rudy1904/Knobpad/README.md

# Knob — panda MIDI keypad

Panda-shaped USB-MIDI controller for Hack Club Half Life (Tier 1): 8 Kailh Choc V1 keys, EC11 encoder, rotary pot, WS2812B underglow, LOLIN S3 Mini (ESP32-S3).

## Status

| Phase | State |
| --- | --- |
| 1. Prep — parts, pinout, footprints | done → `docs/phase1-prep.md` |
| 2. Schematic | done, in review → `docs/phase2-4.md` (ERC 0/0) |
| 3. Footprints + pin check | done, in review → `docs/phase2-4.md` |
| 4. Panda outline | done, in review → `docs/phase2-4.md` (96 × 94 mm, DRC 0) |
| 5. Placement | not started |
| 6. Routing | not started |
| 7. Silkscreen art | not started |
| 8. DRC + exports | not started |
| 9. Firmware | not started |
| 10. Repo + submit | not started |

## Layout

```
hardware/        KiCad 10 project — open hardware/knob.kicad_pro
hardware/lib/    project-local footprints/symbols (Choc V1, S3 Mini)
firmware/        CircuitPython (Phase 9)
docs/            phase notes, parts draft, schematic PDF, images
reports/         ERC / DRC reports
```

`BOM.md` and `JOURNAL.md` are generated by Half Life on sync — don't hand-edit them.
