rudy1904/Knobpad/docs/ref/README.md

# Reference documents (official sources)

- LOLIN S3 Mini page (pinout image, specs): https://www.wemos.cc/en/latest/s3/s3_mini.html
- S3 Mini schematic v1.0.0: https://www.wemos.cc/en/latest/_static/files/sch_s3_mini_v1.0.0.pdf
- S3 Mini dimensions v1.0.0: https://www.wemos.cc/en/latest/_static/files/dim_s3_mini_v1.0.0.pdf
- CircuitPython board pins (lolin_s3_mini): https://github.com/adafruit/circuitpython/blob/main/ports/espressif/boards/lolin_s3_mini/pins.c
- ESP32-S3 datasheet: https://www.espressif.com/sites/default/files/documentation/esp32-s3_datasheet_en.pdf
- WS2812B-B/T datasheet (LCSC C2761795): https://datasheet.lcsc.com/datasheet/pdf/bc8264a6d62c958a89e25ec8cc82b690.pdf?productCode=C2761795
- Bourns PTV09 datasheet: https://www.bourns.com/data/global/pdfs/PTV09.pdf
- Alps EC11E18244A5 (LCSC C255515): https://www.lcsc.com/product-detail/C255515.html
- Kailh Choc V1 footprint source: https://github.com/kiswitch/keyswitch-kicad-library

Wemos' site blocks direct downloads from scripts; open these in a browser and drop the PDFs here if you want offline copies.
