rudy1904/Knobpad/docs/img/cover.png

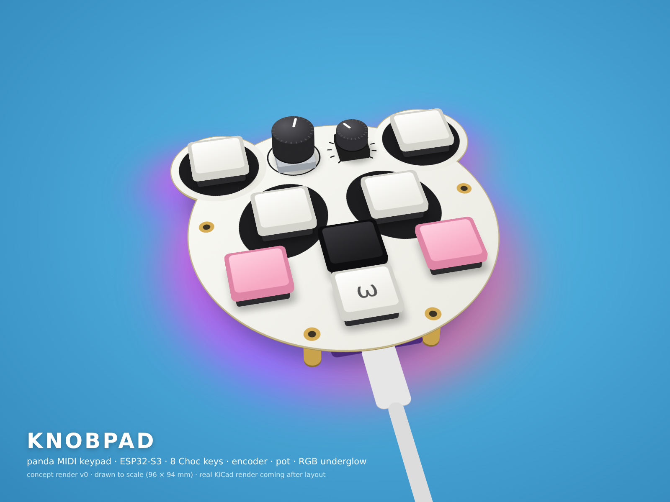
docs/img/cover.png
