rudy1904/Knobpad/docs/img/phase1-pinmap.png

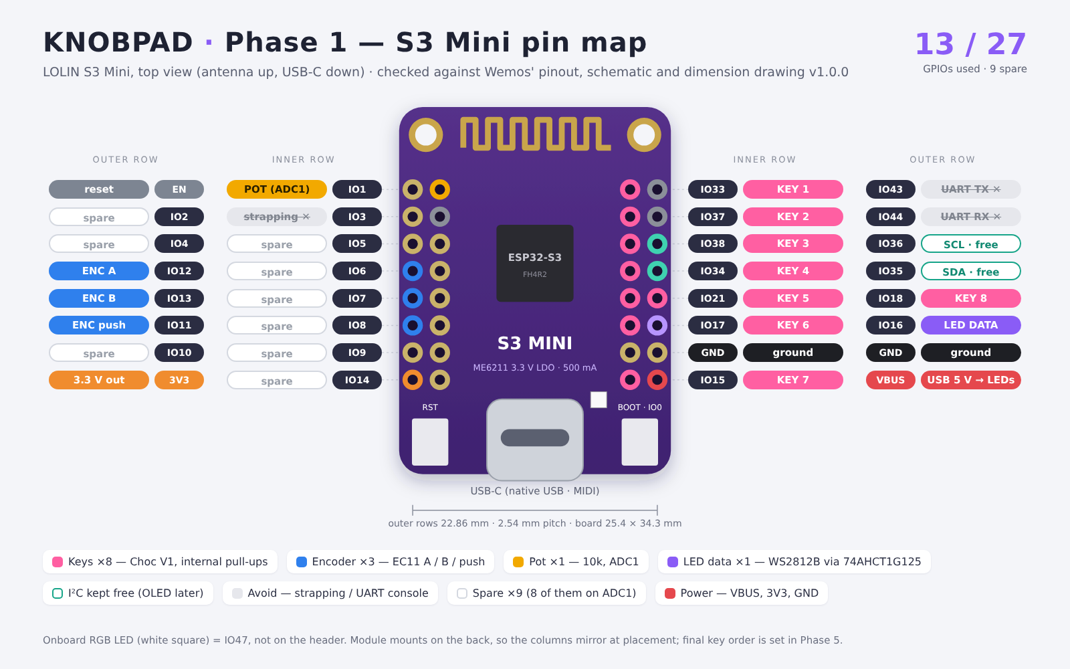
docs/img/phase1-pinmap.png
