rudy1904/Knobpad/docs/img/phase4-outline-top.png

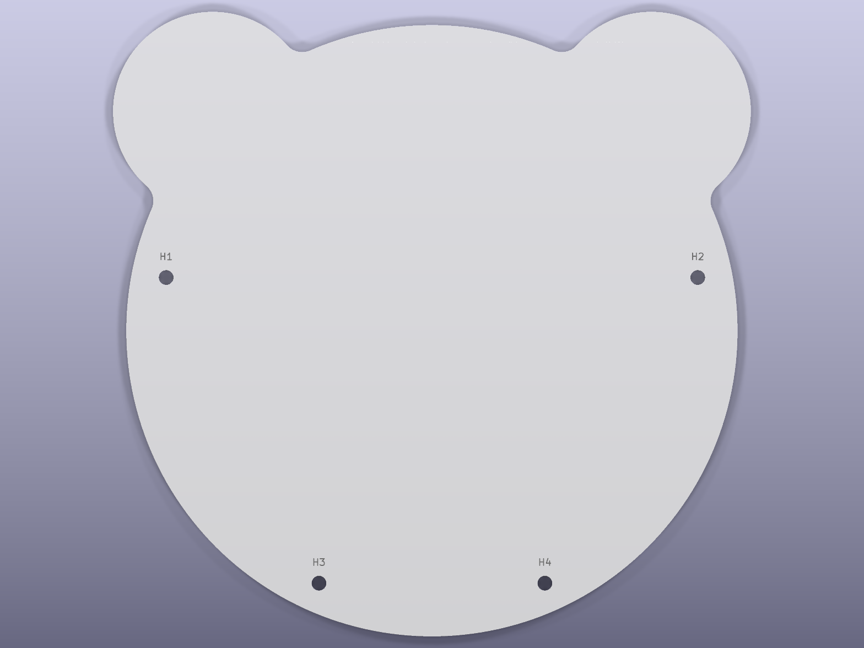
docs/img/phase4-outline-top.png
