rudy1904/Knobpad/BOM.csv

Item | Qty | Supplier | Cost/item | Total Cost | link
Estimated total shipping | 1 |  |  | $0.00
