rudy1904/Knobpad/docs/knob-schematic.pdf

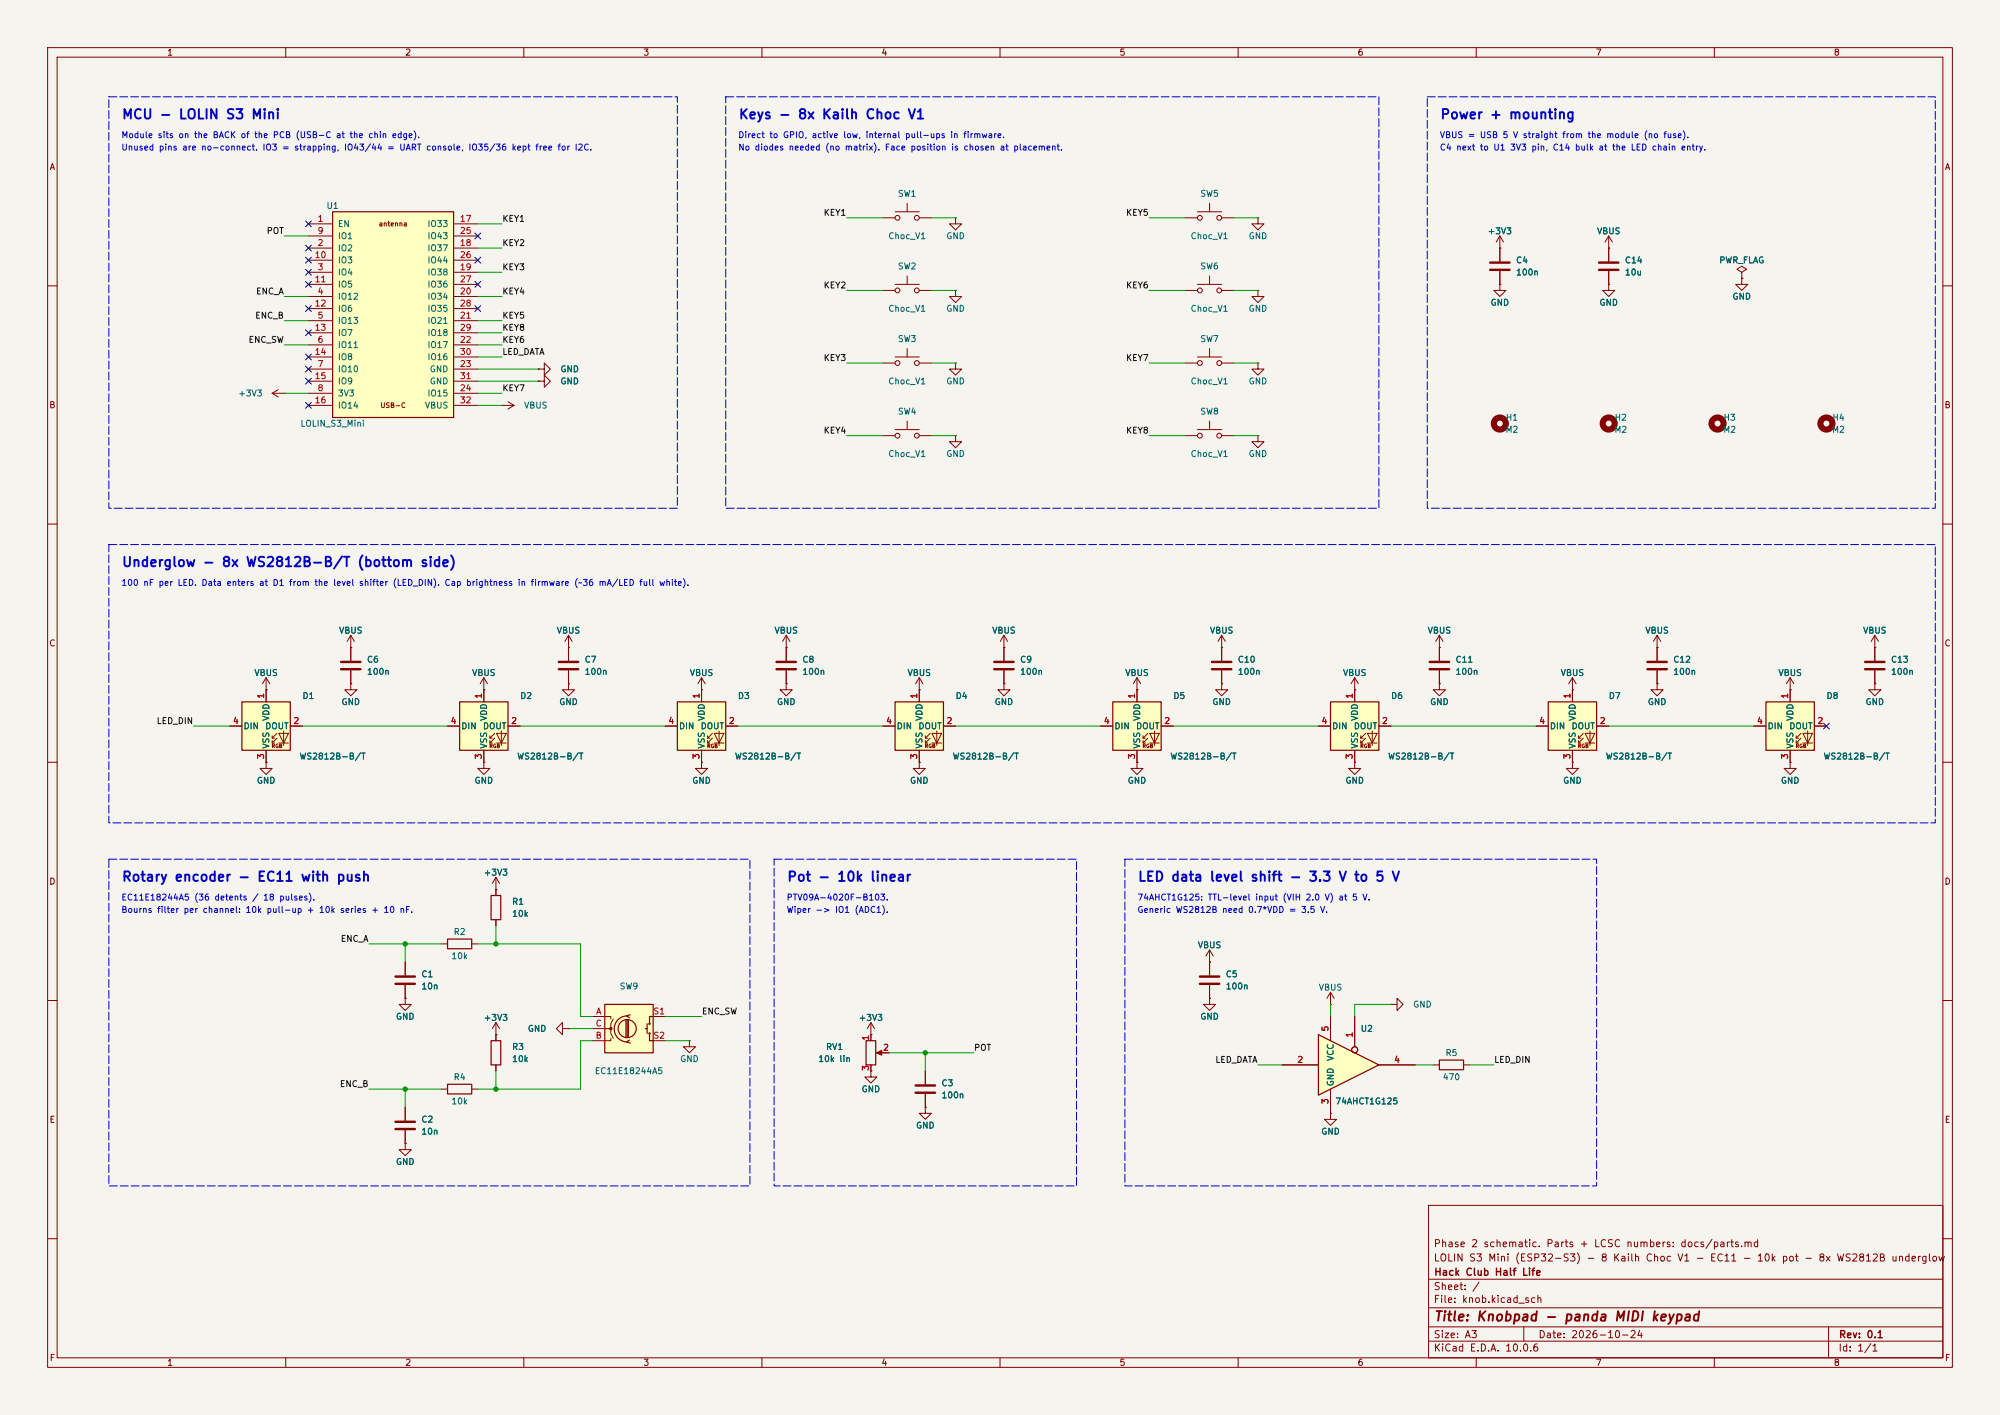
[picture p7: page 1]

Module sits on the BACK of the PCB (USB-C at the chin edge). 100 nF per LED. Data enters at D1 from the level shifter (LED_DIN). Cap brightness in firmware (~36 mA/LED full white).

Direct to GPIO, active low, internal pull-ups in firmware.
No diodes needed (no matrix). Face position is chosen at placement.

C4 next to U1 3V3 pin, C14 bulk at the LED chain entry.

Bourns filter per channel: 10k pull-up + 10k series + 10 nF. Rotary encoder - EC11 with push

Phase 2 schematic. Parts + LCSC numbers: docs/parts.md
LOLIN S3 Mini (ESP32-S3) - 8 Kailh Choc V1 - EC11 - 10k pot - 8x WS2812B underglow
Hack Club Half Life
Sheet: /
File: knob.kicad_sch
Title: Knobpad - panda MIDI keypad

Size: A3 | Rev: 0.1 | F Date: 2026-10-24
KiCad E.D.A. 10.0.6 | Id: 1/1
