rudy1904/Knobpad/hardware/knob.kicad_pcb

## KiCad design hardware/knob.kicad_pcb (2026-10-24)

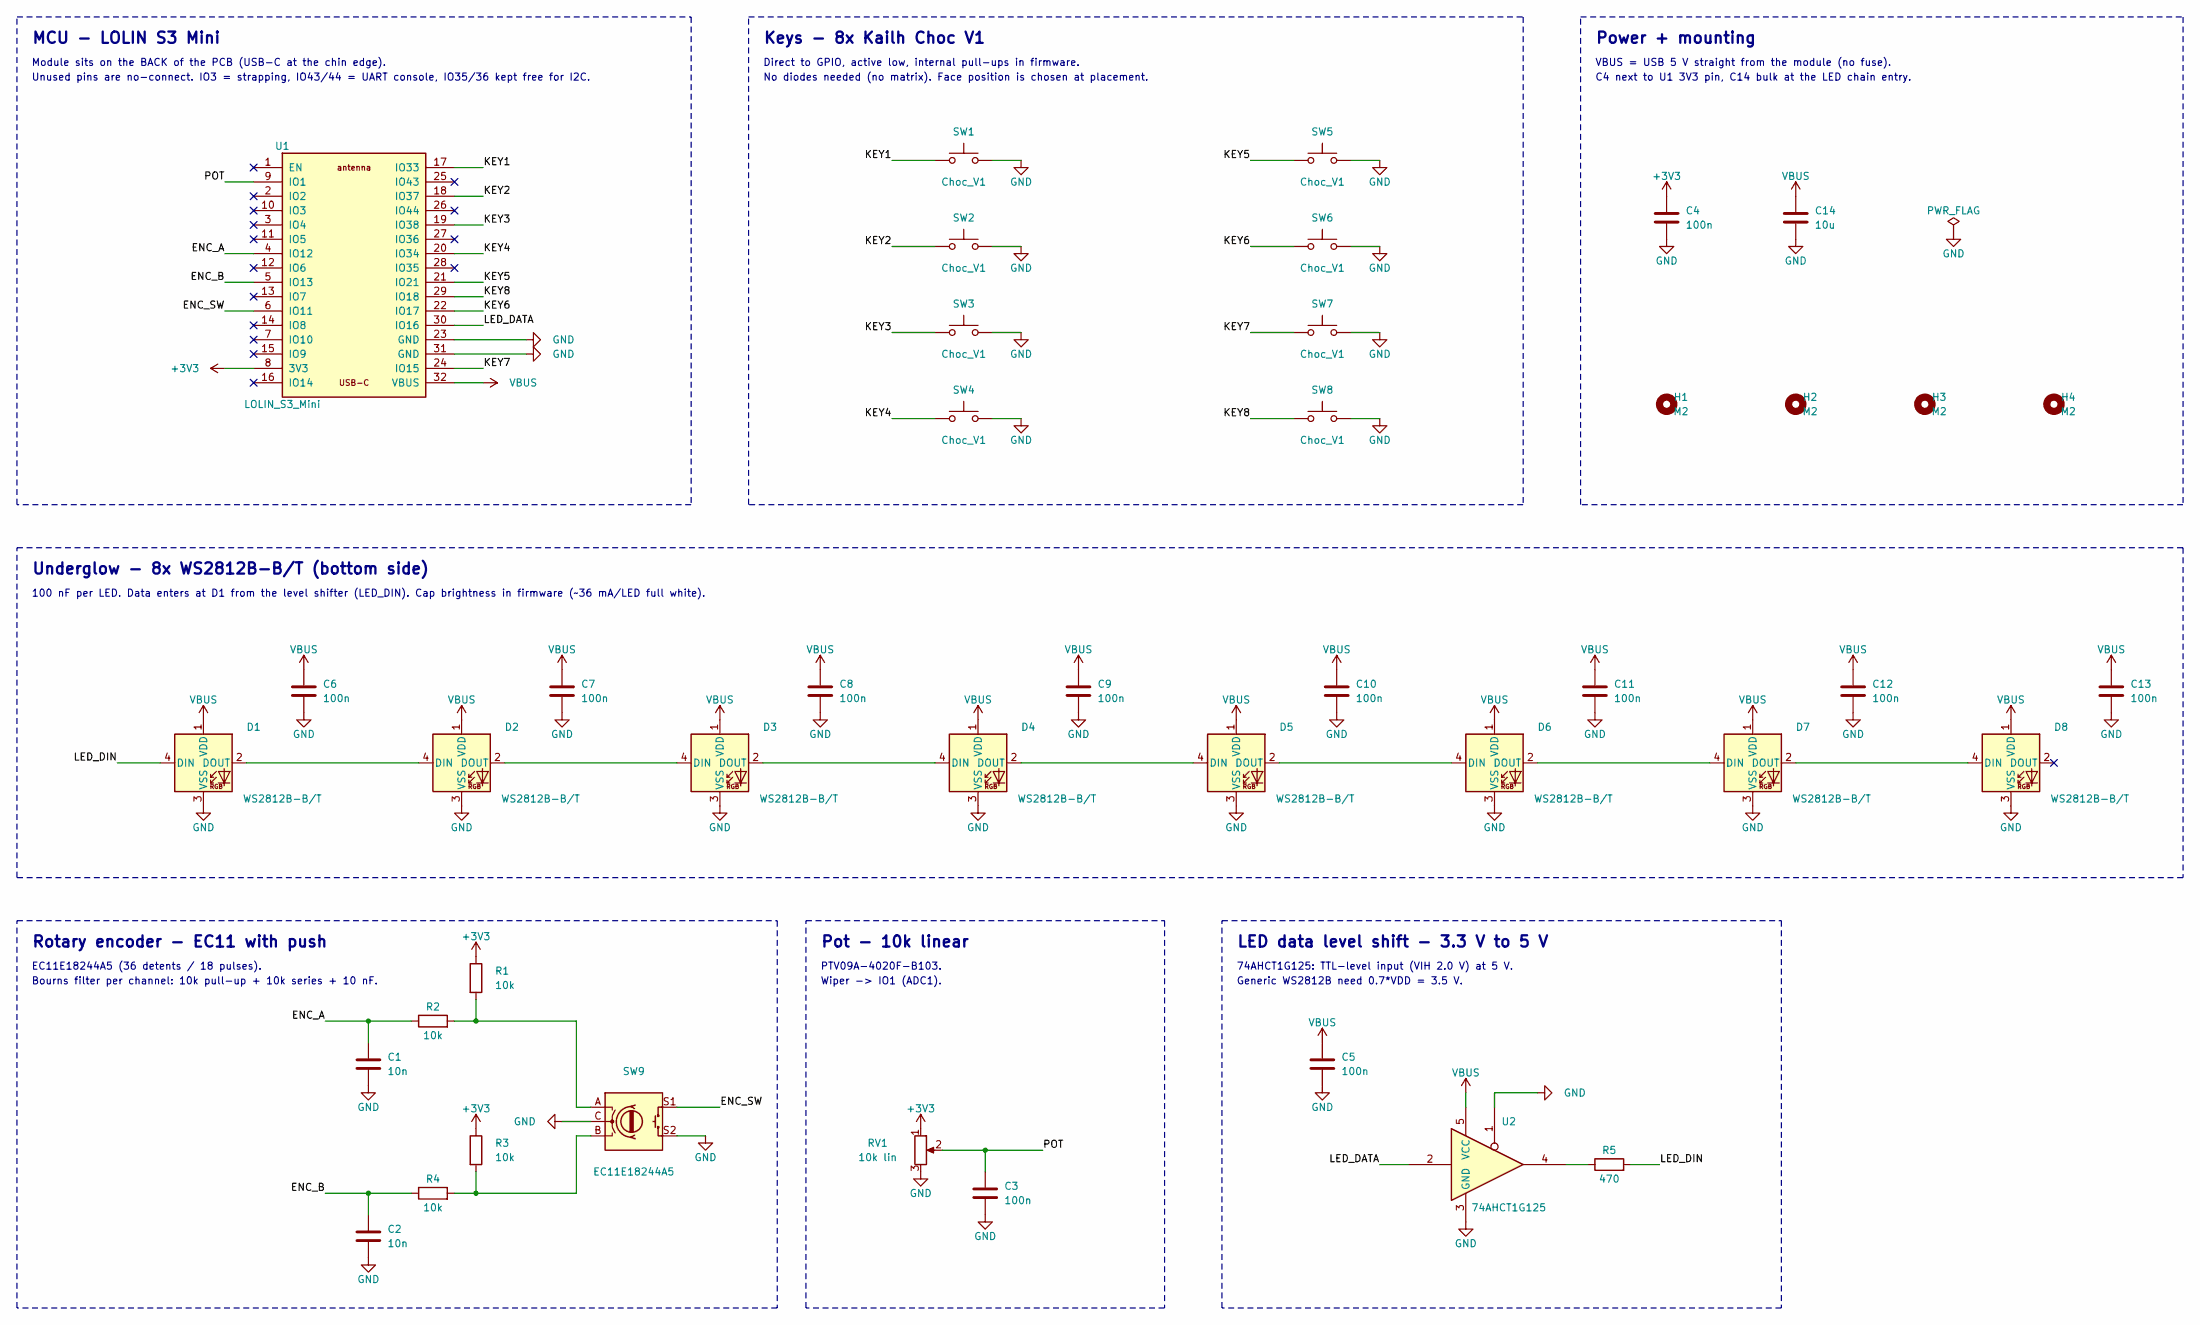
[picture p8: schematic knob.kicad_sch, Knobpad - panda MIDI keypad]

Parts:
C1, C2: 10n; C_0805_2012Metric; MPN CC0805KRX7R9BB103; LCSC C83170
C3, C4, C5, C6, C7, C8, C9, C10, C11, C12, C13: 100n; C_0805_2012Metric; MPN CC0805KRX7R9BB104; LCSC C49678
C14: 10u; C_0805_2012Metric; MPN CL21A106KAYNNNE; LCSC C15850
D1, D2, D3, D4, D5, D6, D7, D8: WS2812B-B/T; LED_WS2812B_PLCC4_5.0x5.0mm_P3.2mm; MPN WS2812B-B/T; LCSC C2761795
H1, H2, H3, H4: M2; MountingHole_2.2mm_M2
R1, R2, R3, R4: 10k; R_0805_2012Metric; MPN 0805W8F1002T5E; LCSC C17414
R5: 470; R_0805_2012Metric; MPN 0805W8F4700T5E; LCSC C17710
RV1: 10k lin; Potentiometer_Bourns_PTV09A-1_Single_Vertical; MPN PTV09A-4020F-B103; LCSC C5848782
SW1, SW2, SW3, SW4, SW5, SW6, SW7, SW8: Choc_V1; SW_Kailh_Choc_V1_1.00u; MPN Kailh CPG1350 (Choc V1)
SW9: EC11E18244A5; RotaryEncoder_Alps_EC11E-Switch_Vertical_H20mm; MPN EC11E18244A5; LCSC C255515
U1: LOLIN_S3_Mini; MPN LOLIN S3 Mini v1.0.0
U2: 74AHCT1G125; SOT-23-5; MPN SN74AHCT1G125DBVR; LCSC C7484

Connections:
+3V3: C4.1, R1.1, R3.1, RV1.1, U1.8 (3V3)
/ENC_A: C1.1, R2.1, U1.4 (IO12)
/ENC_B: C2.1, R4.1, U1.5 (IO13)
/ENC_SW: SW9.S1, U1.6 (IO11)
/KEY1: SW1.1, U1.17 (IO33)
/KEY2: SW2.1, U1.18 (IO37)
/KEY3: SW3.1, U1.19 (IO38)
/KEY4: SW4.1, U1.20 (IO34)
/KEY5: SW5.1, U1.21 (IO21)
/KEY6: SW6.1, U1.22 (IO17)
/KEY7: SW7.1, U1.24 (IO15)
/KEY8: SW8.1, U1.29 (IO18)
/LED_DATA: U1.30 (IO16), U2.2
/LED_DIN: D1.4 (DIN), R5.2
/POT: C3.1, RV1.2, U1.9 (IO1)
GND: C1.2, C2.2, C3.2, C4.2, C5.2, C6.2, C7.2, C8.2, C9.2, C10.2, C11.2, C12.2, C13.2, C14.2, D1.3 (VSS), D2.3 (VSS), D3.3 (VSS), D4.3 (VSS), D5.3 (VSS), D6.3 (VSS), D7.3 (VSS), D8.3 (VSS), RV1.3, SW1.2, SW2.2, SW3.2, SW4.2, SW5.2, SW6.2, SW7.2, SW8.2, SW9.C, SW9.S2, U1.23 (GND), U1.31 (GND), U2.1, U2.3 (GND)
unnamed: D1.2 (DOUT), D2.4 (DIN)
unnamed: D2.2 (DOUT), D3.4 (DIN)
unnamed: D3.2 (DOUT), D4.4 (DIN)
unnamed: D4.2 (DOUT), D5.4 (DIN)
unnamed: D5.2 (DOUT), D6.4 (DIN)
unnamed: D6.2 (DOUT), D7.4 (DIN)
unnamed: D7.2 (DOUT), D8.4 (DIN)
unnamed: R1.2, R2.2, SW9.A
unnamed: R3.2, R4.2, SW9.B
unnamed: R5.1, U2.4
VBUS: C5.1, C6.1, C7.1, C8.1, C9.1, C10.1, C11.1, C12.1, C13.1, C14.1, D1.1 (VDD), D2.1 (VDD), D3.1 (VDD), D4.1 (VDD), D5.1 (VDD), D6.1 (VDD), D7.1 (VDD), D8.1 (VDD), U1.32 (VBUS), U2.5 (VCC)

Notes on the sheet:
Rotary encoder - EC11 with push
No diodes needed (no matrix). Face position is chosen at placement.
C4 next to U1 3V3 pin, C14 bulk at the LED chain entry.
LED data level shift - 3.3 V to 5 V
PTV09A-4020F-B103.
Generic WS2812B need 0.7*VDD = 3.5 V.
Module sits on the BACK of the PCB (USB-C at the chin edge).
Pot - 10k linear
Keys - 8x Kailh Choc V1
Underglow - 8x WS2812B-B/T (bottom side)
Wiper -> IO1 (ADC1).
Direct to GPIO, active low, internal pull-ups in firmware.
Power + mounting
MCU - LOLIN S3 Mini
Unused pins are no-connect. IO3 = strapping, IO43/44 = UART console, IO35/36 kept free for I2C.
Bourns filter per channel: 10k pull-up + 10k series + 10 nF.
EC11E18244A5 (36 detents / 18 pulses).
74AHCT1G125: TTL-level input (VIH 2.0 V) at 5 V.
100 nF per LED. Data enters at D1 from the level shifter (LED_DIN). Cap brightness in firmware (~36 mA/LED full white).
VBUS = USB 5 V straight from the module (no fuse).

Board: 2 copper layers, 43 parts (9 on the bottom side), 27 nets, no tracks yet.
