rudy1904/Knobpad/JOURNAL.md

# Knobpad – devlog

<!-- Generated by Half Life from project cmuvbkmu40g5z01sm3a0c4mfp. Edits here are overwritten on the next sync. -->
<!-- Generated: 1970-01-01T00:00:00.000Z -->

> [!NOTE]
> This devlog is mirrored from [Half Life](https://halflife.hackclub.com) – [open the project](https://halflife.hackclub.com/projects/cmuvbkmu40g5z01sm3a0c4mfp). Editing it here will not change the platform's copy, and the next sync overwrites this file.

> A polished 9-key USB macropad with a rotary knob, a small OLED and per-key RGB, run by a Seeed XIAO RP2040. This stage is PCB design only: schematic, BOM and a 2-layer board, with a 3D-printed case to follow.

| Week | Tier | Hours logged | Entries |
| --- | --- | --- | --- |
| Week 1 | Tier 1 | 0h | 0 |

_No entries logged yet._
