rudy1904/Knobpad/(commit log)

2026-10-23 Sync Knobpad from Half Life
    [BOM.csv]
2026-10-23 Phase 1: prep - verified pinout, parts list, Choc footprint
2026-10-23 Phase 1: pin map image, fix ADC note
2026-10-24 Phases 2-4: schematic, footprints, panda outline
    [knob.kicad_pcb, knob.kicad_sch]
